seismicindustries/TT/info/linux_commands_for_AP_Client_mode_stuff_terminal_tedium.rtf

IP setzen
*********

ifconfig eth0 10.0.0.1

IP loeschen
***********

ifconfig eth0 0.0.0.0 - testen… sollte auch alle ips löschen vom interface

Use ip from iproute2. (You need to also specify the prefix length though.)
ip addr del 10.22.30.44/16 dev eth0

To remove all addresses (in case you have multiple):
ip addr flush dev eth0

DHCP start stop
***************

Restart the DCHP Service so that it will load your new settings:
service isc-dhcpd-server stop
service isc-dhcpd-server start
