seismicindustries/TT/(list of files, drawings)

Other design files:
TT.dsn
