seismicindustries/TT/TT.kicad_pcb

## KiCad design TT.kicad_pcb (2018-06-29)

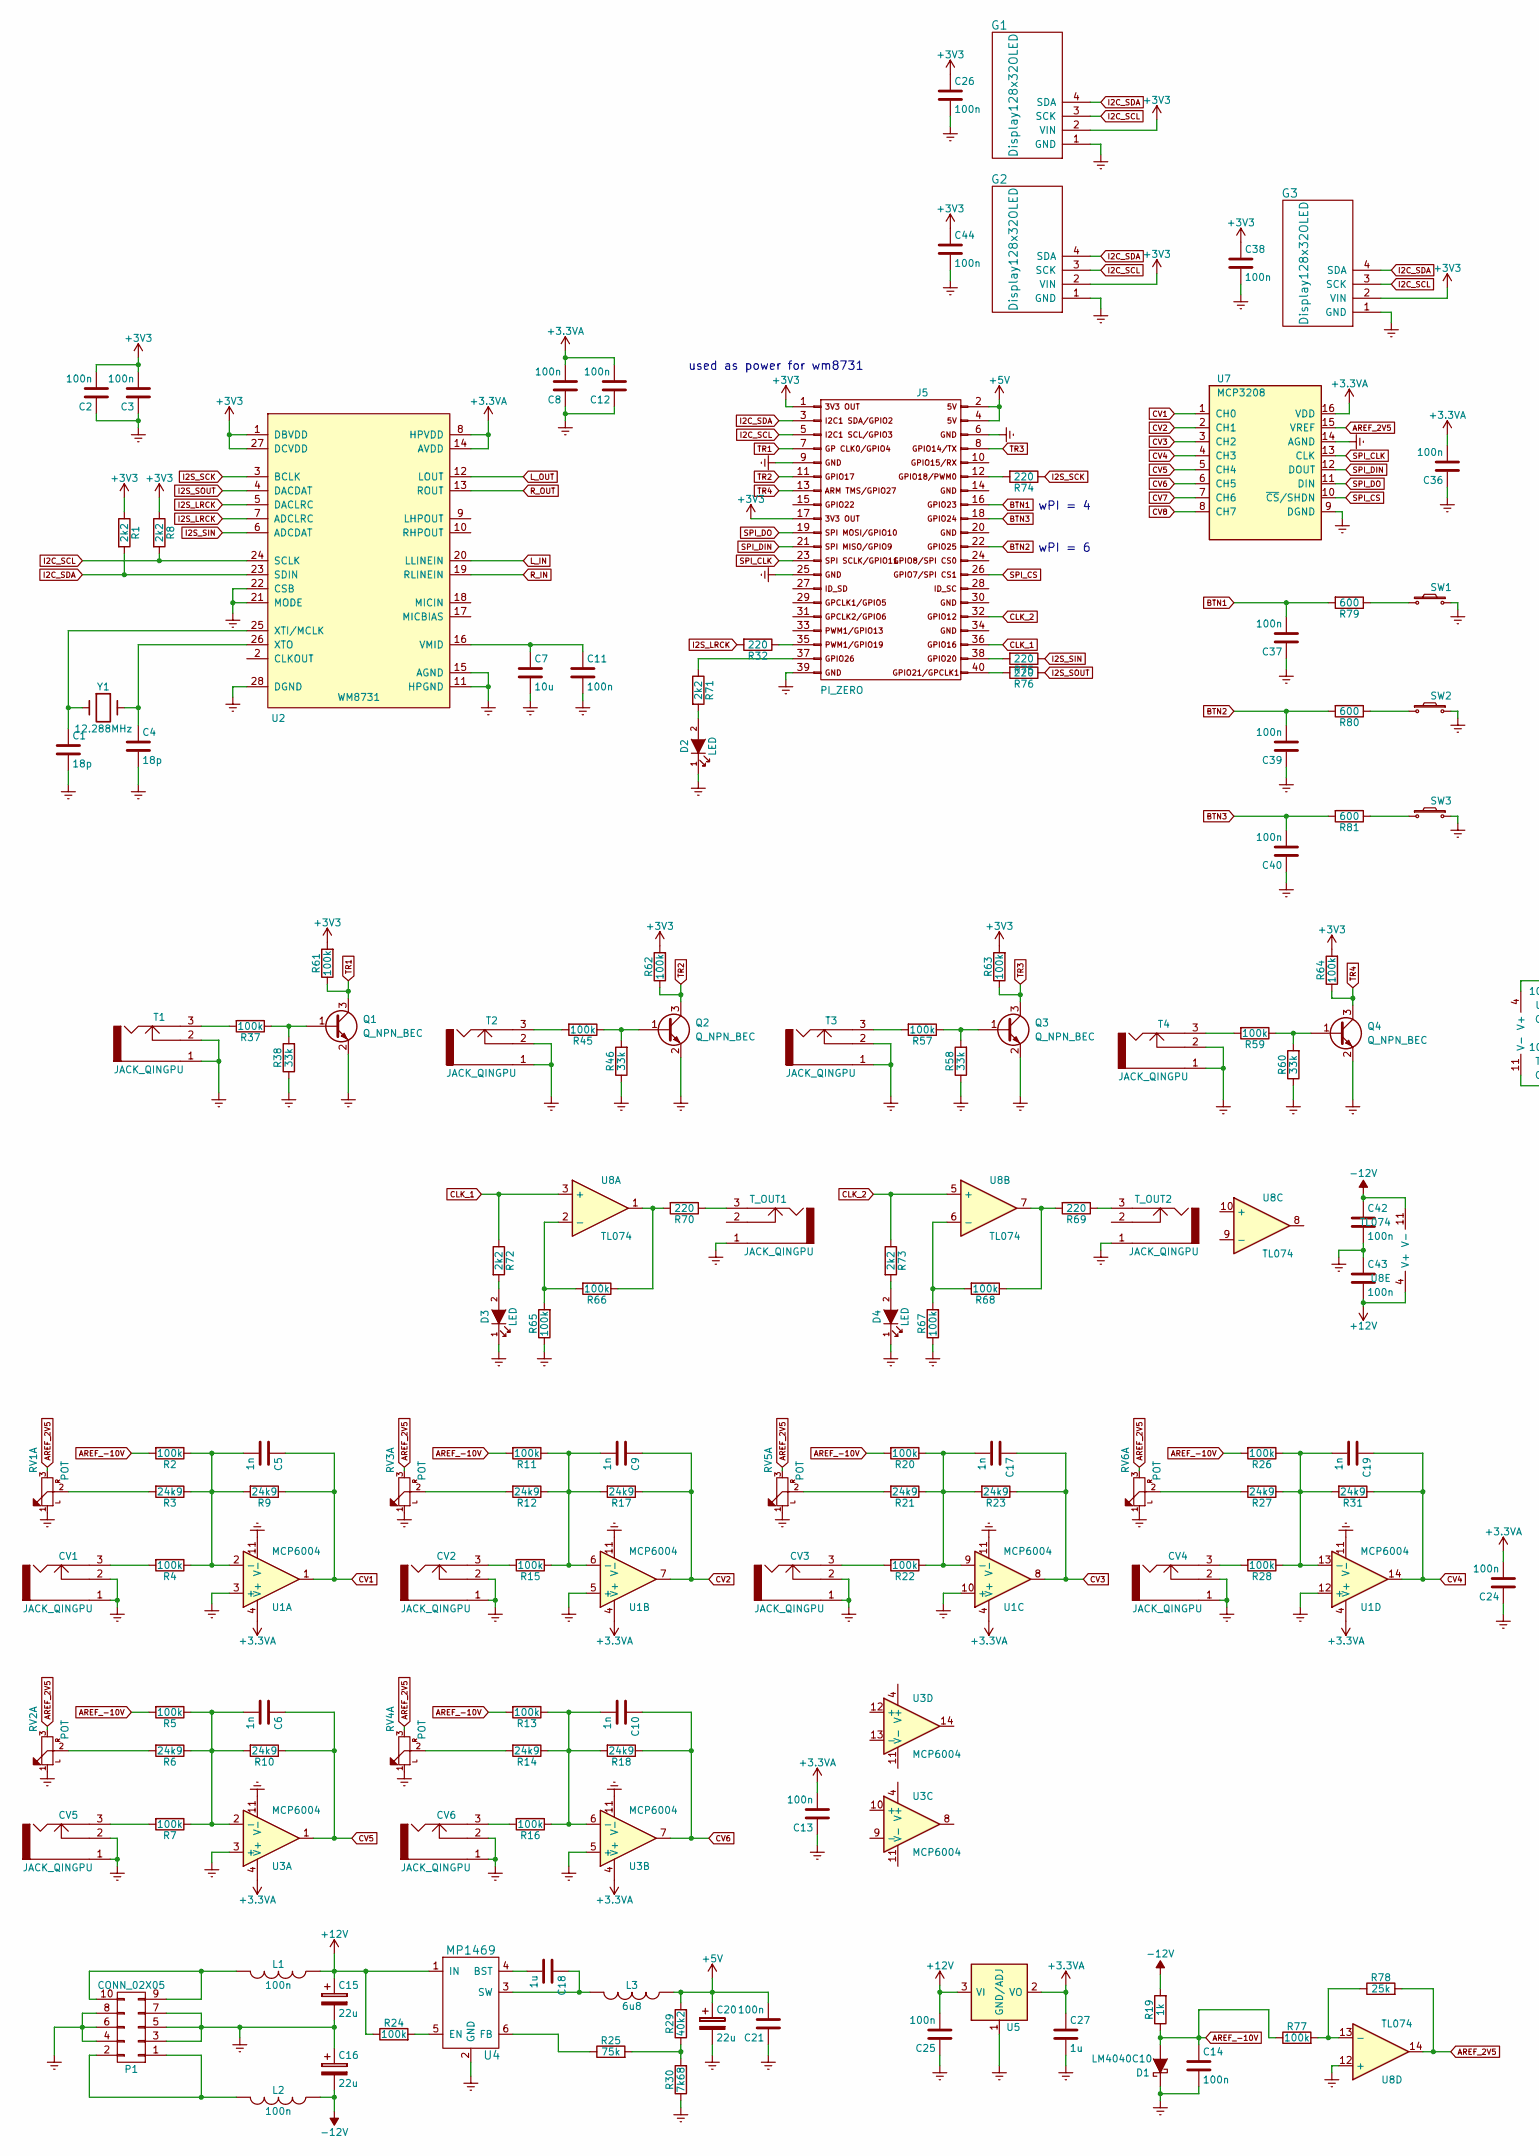
[picture p1: schematic TT.sch, TT remake, part in row 1, column 1]

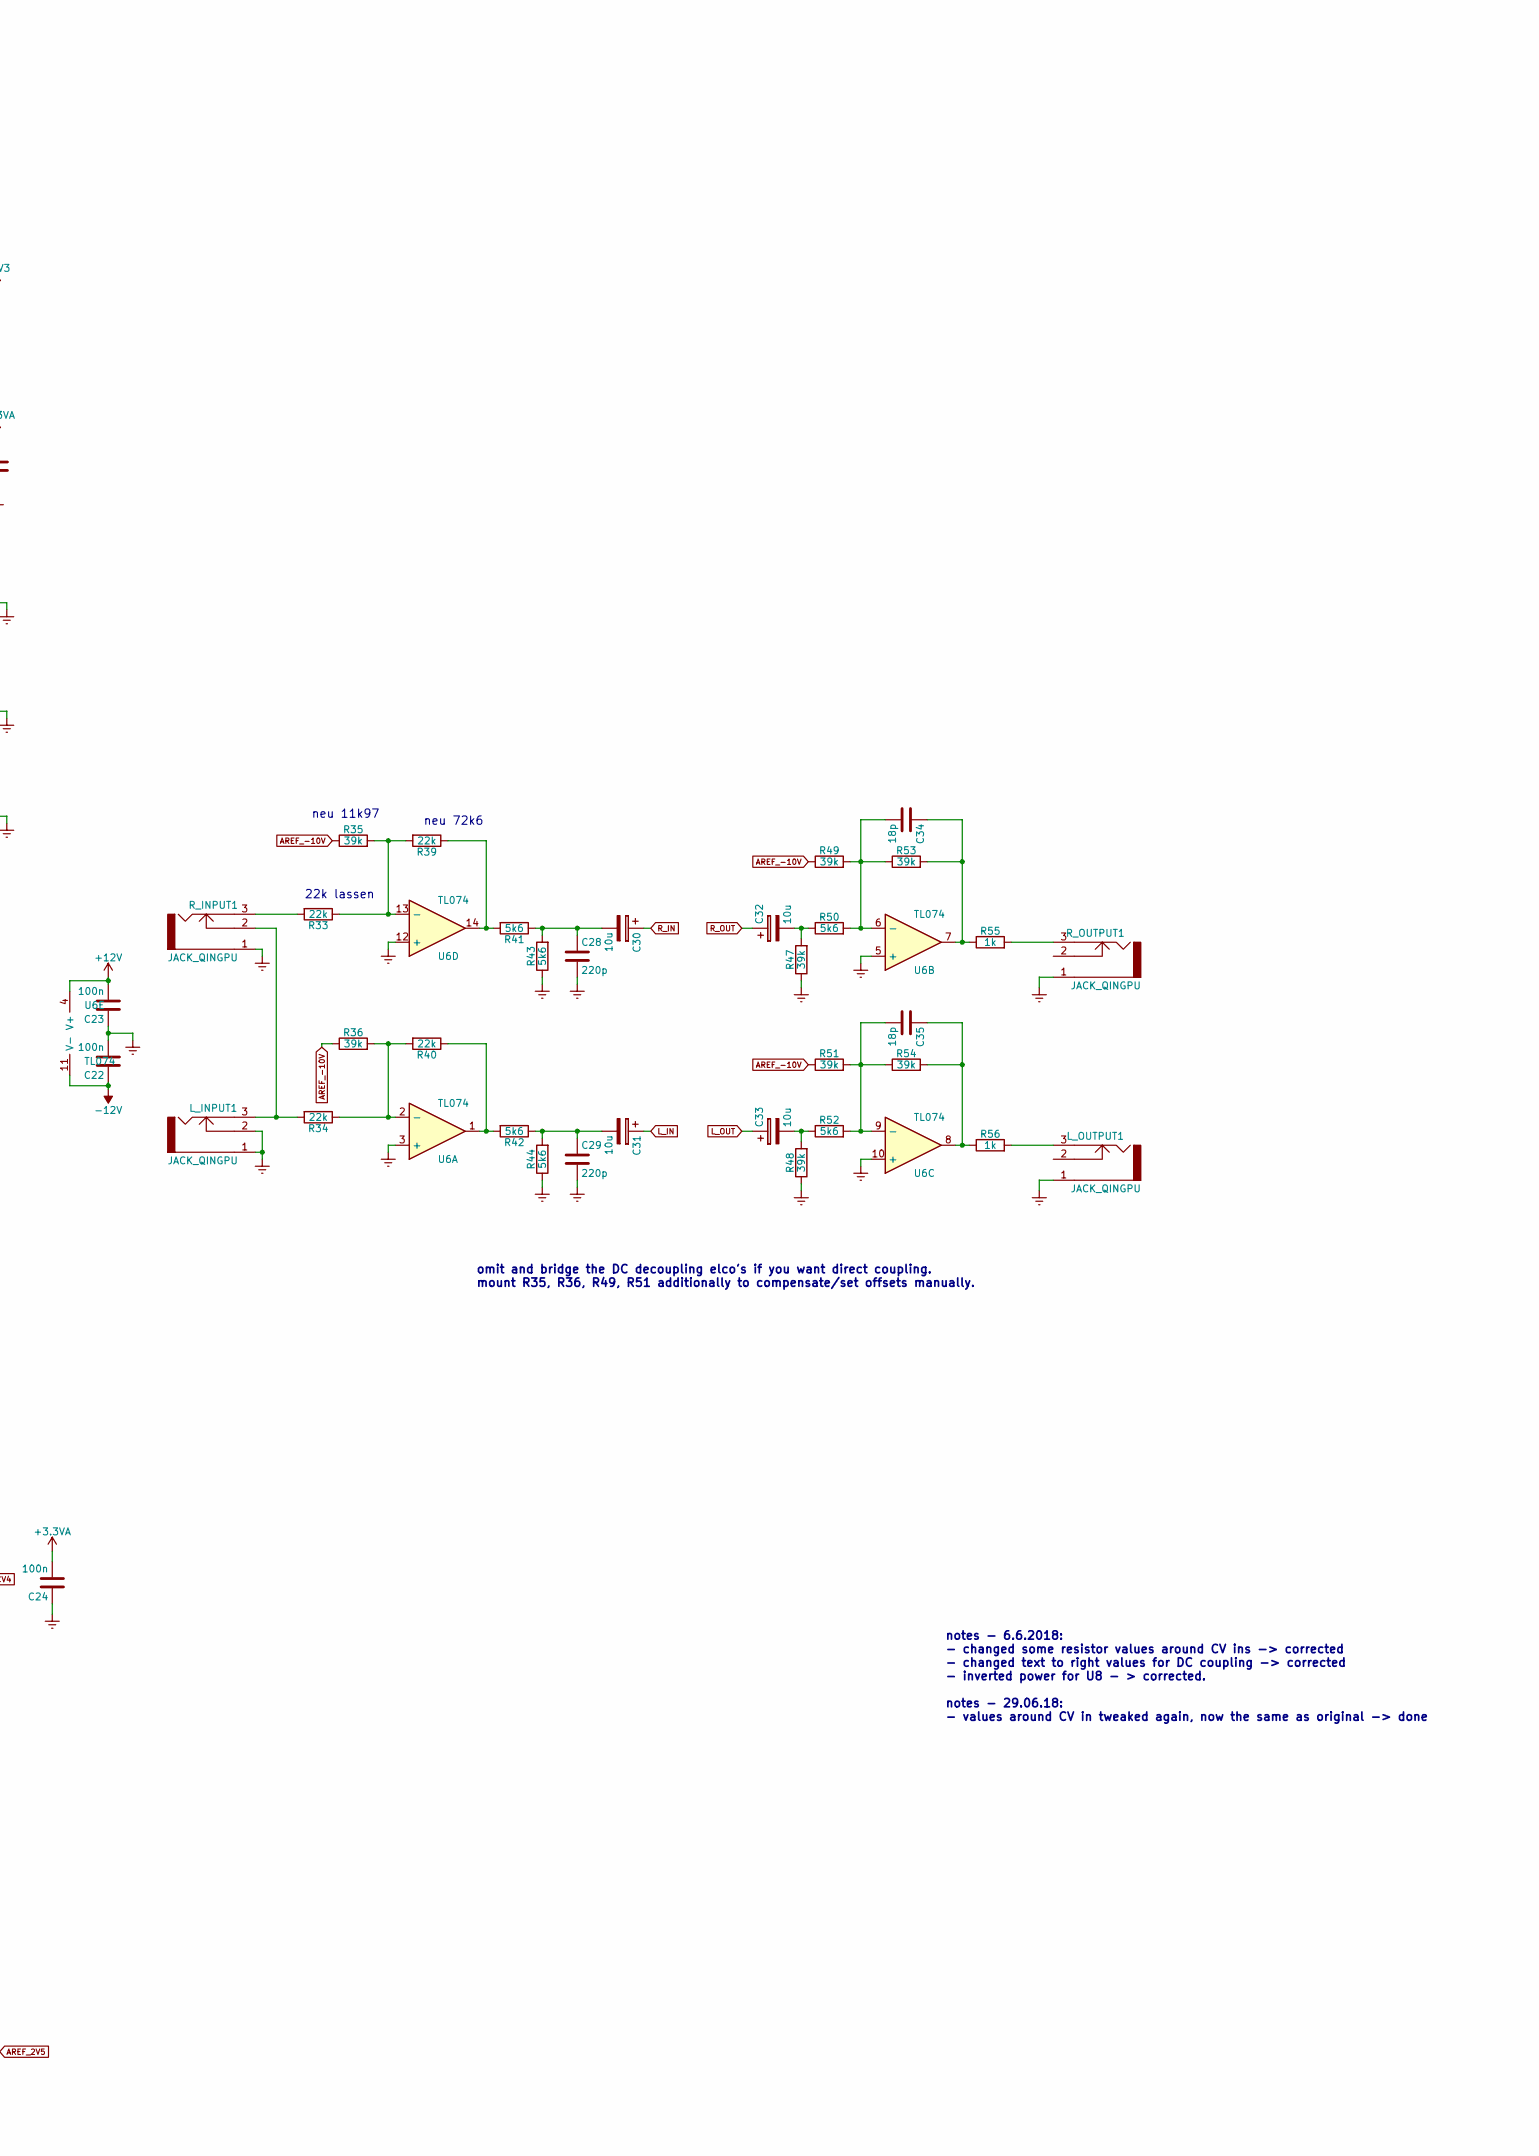
[picture p2: schematic TT.sch, TT remake, part in row 1, column 2]

Parts:
C1, C4, C34, C35: 18p; C_0603; MPN VJ0603A180JXACW1BC
C2, C3, C8, C11, C12, C13, C14, C21, C22, C23, C24, C25, C26, C36, C37, C38, C39, C40, C42, C43, C44: 100n; C_0603; MPN 885012206095
C5, C6, C9, C10, C17, C19: 1n; C_0603; MPN GRM1885C1H102JA01D
C7: 10u; C_0603; Mouser Part Nr 810-C1608X5R0J106M
C15, C16, C20: 22u; CP_Elec_7.3x4.3; MPN EEF-CX1D220R
C18, C27: 1u; C_0603; MPN 885012206095
C28, C29: 220p; C_0603; MPN GRM1885C1H221JA01J
C30, C31, C32, C33: 10u; C_Radial_D4_L7; MPN UPW1E100MDD6
CV1, CV2, CV3, CV4, CV5, CV6: JACK_QINGPU; jack_qingpu
D1: LM4040C10; SOT-23; MPN LM4040C10IDBZR
D2, D3, D4: LED; LED_D3.0mm; MPN LTL-4231N
G1, G2, G3: Display128x32OLED; oled_128x32
J5: PI_ZERO
L1, L2: 100n; Inductor_PSU_NLCV32T; MPN NLCV32T-R10M-PFR
L3: 6u8; Inductor_SRN4018TA_bourns; MPN SRN4018TA-6R8M
L_INPUT1: JACK_QINGPU; jack_qingpu
L_OUTPUT1: JACK_QINGPU; jack_qingpu
P1: CONN_02X05; Pin_Header_Angled_2x05_Pitch2.54mm_with_space_for_con; MPN 649-68020-110HLF
Q1, Q2, Q3, Q4: Q_NPN_BEC; SOT-23; MPN BC847CLT1G
R1, R8, R71, R72, R73: 2k2; R_0603; MPN RC0603FR-072K2L
R2, R5, R11, R13, R20, R26: 100k; R_0603; MPN RC0603FR-07200KL
R3, R6, R12, R14, R21, R27: 24k9; R_0603; MPN RCA0603100KJNEC
R4, R7, R15, R16, R22, R24, R28, R37, R45, R57, R59, R61, R62, R63, R64, R65, R66, R67, R68, R77: 100k; R_0603; MPN RCA0603100KJNEC
R9, R10, R17, R18, R23, R31: 24k9; R_0603; MPN ERJ-3GEYJ333V
R19: 1k; R_0603; MPN ERJ-3GEYJ333V
R25: 75k; R_0603; MPN CR0603-FX-2202ELF
R29: 40k2; R_0603; MPN CR0603-FX-2202ELF
R30: 7k68; R_0603; MPN CR0603-FX-2202ELF
R32, R69, R70, R74, R75, R76: 220; R_0603; MPN RCA0603100KJNEC
R33, R34, R39, R40: 22k; R_0603; MPN CR0603-FX-2202ELF
R35, R36, R47, R48, R49, R51, R53, R54: 39k; R_0603; MPN ERJ-3GEYJ393V
R38, R46, R58, R60: 33k; R_0603; MPN ERJ-3GEYJ333V
R41, R42, R43, R44, R50, R52: 5k6; R_0603; MPN CR0603-FX-5601ELF
R55, R56: 1k; R_0603; MPN RC0603FR-071KL
R78: 25k; R_0603; MPN ERJ-3GEYJ333V
R79, R80, R81: 600; R_0603; MPN RCA0603100KJNEC
RV1, RV2, RV3, RV4, RV5, RV6: POT; Potentiometer_ALPHA_RV112
R_INPUT1: JACK_QINGPU; jack_qingpu
R_OUTPUT1: JACK_QINGPU; jack_qingpu
SW1, SW2, SW3: SW_PUSH_SMALL_H; APEM_tactile_SMD_switch_6mm; MPN ADTSM66NV
T1, T2, T3, T4: JACK_QINGPU; jack_qingpu
T_OUT1, T_OUT2: JACK_QINGPU; jack_qingpu
U1, U3: MCP6004; SOIC-14_N; MPN MCP6004T-I/SL SOIC-14 variant
U2: WM8731; SSOP-28_5.3x10.2mm_Pitch0.65mm; MPN WM8731SEDS/V
U4: MP1469; SOT-23-6; MPN MP1469GJ-Z
U5: SOT-223; MPN AZ1117IH-3.3TRG1 SOT-223-3 variant
U6, U8: TL074; SOIC-14_N; MPN 595-TL074CDR SOIC-14 variant
U7: MCP3208; SO-16-N
Y1: 12.288MHz; ABM7; Mouser Part Nr 815-ABM7-12.2-D2Y-T

Connections:
+3.3VA: C8.2, C12.2, C13.2, C24.2, C27.1, C36.2, U1.4 (V+), U2.8 (HPVDD), U2.14 (AVDD), U3.4 (V+), U5.2 (VO), U7.16 (VDD)
+3V3: C2.2, C3.2, C26.1, C38.1, C44.1, G1.2 (VIN), G2.2 (VIN), G3.2 (VIN), J5.1, J5.17, R1.1, R8.1, R61.2, R62.2, R63.2, R64.2, U2.1 (DBVDD), U2.27 (DCVDD)
+5V: C20.1, C21.2, J5.2, J5.4, L3.1, R29.2
+12V: C15.1, C23.2, C25.2, C43.2, L1.1, R24.1, U4.1 (IN), U5.3 (VI), U6.4 (V+), U8.4 (V+)
-12V: C16.2, C22.1, C42.1, L2.1, R19.2, U6.11 (V-), U8.11 (V-)
AREF_2V5: R78.2, RV1.3 (6), RV2.3 (6), RV3.3 (6), RV4.3 (6), RV5.3 (6), RV6.3 (6), U7.15 (VREF), U8.14
AREF_-10V: C14.1, D1.2 (A), R2.2, R5.2, R11.2, R13.2, R19.1, R20.2, R26.2, R35.1, R36.1, R49.1, R51.1, R77.1
BTN1: C37.2, J5.16, R79.2
BTN2: C39.2, J5.22, R80.2
BTN3: C40.2, J5.18, R81.2
CLK_1: J5.36, R72.1, U8.3 (+)
CLK_2: J5.32, R73.1, U8.5 (+)
CV1: C5.1, R9.1, U1.1, U7.1 (CH0)
CV2: C9.1, R17.1, U1.7, U7.2 (CH1)
CV3: C17.1, R23.1, U1.8, U7.3 (CH2)
CV4: C19.1, R31.1, U1.14, U7.4 (CH3)
CV5: C6.1, R10.1, U3.1, U7.5 (CH4)
CV6: C10.1, R18.1, U3.7, U7.6 (CH5)
Earth: C1.2, C2.1, C3.1, C4.2, C7.2, C8.1, C11.2, C12.1, C13.1, C14.2, C15.2, C16.1, C20.2, C21.1, C22.2, C23.1, C24.1, C25.1, C26.2, C27.2, C28.2, C29.2, C36.1, C37.1, C38.2, C39.1, C40.1, C42.2, C43.1, C44.2, CV1.1, CV1.2, CV2.1, CV2.2, CV3.1, CV3.2, CV4.1, CV4.2, CV5.1, CV5.2, CV6.1, CV6.2, D1.1 (K), D2.1 (K), D3.1 (K), D4.1 (K), G1.1 (GND), G2.1 (GND), G3.1 (GND), J5.6, J5.9, J5.25, J5.39, L_INPUT1.1, L_INPUT1.2, L_OUTPUT1.1, P1.3, P1.4, P1.5, P1.6, P1.7, P1.8, Q1.2 (E), Q2.2 (E), Q3.2 (E), Q4.2 (E), R30.1, R38.1, R43.1, R44.1, R46.1, R47.1, R48.1, R58.1, R60.1, R65.1, R67.1, RV1.1 (4), RV2.1 (4), RV3.1 (4), RV4.1 (4), RV5.1 (4), RV6.1 (4), R_INPUT1.1, R_OUTPUT1.1, SW1.2, SW2.2, SW3.2, T1.1, T1.2, T2.1, T2.2, T3.1, T3.2, T4.1, T4.2, T_OUT1.1, T_OUT2.1, U1.3 (+), U1.5 (+), U1.10 (+), U1.11 (V-), U1.12 (+), U2.11 (HPGND), U2.15 (AGND), U2.21 (MODE), U2.22 (CSB), U2.28 (DGND), U3.3 (+), U3.5 (+), U3.11 (V-), U4.2 (GND), U5.1 (GND/ADJ), U6.3 (+), U6.5 (+), U6.10 (+), U6.12 (+), U7.9 (DGND), U7.14 (AGND), U8.12 (+)
I2C_SCL: G1.3 (SCK), G2.3 (SCK), G3.3 (SCK), J5.5, R8.2, U2.24 (SCLK)
I2C_SDA: G1.4 (SDA), G2.4 (SDA), G3.4 (SDA), J5.3, R1.2, U2.23 (SDIN)
I2S_LRCK: R32.2, U2.5 (DACLRC), U2.7 (ADCLRC)
I2S_SCK: R74.1, U2.3 (BCLK)
I2S_SIN: R75.1, U2.6 (ADCDAT)
I2S_SOUT: R76.1, U2.4 (DACDAT)
L_IN: C31.1, U2.20 (LLINEIN)
L_OUT: C33.1, U2.12 (LOUT)
unnamed: C1.1, U2.25 (XTI/MCLK), Y1.1
unnamed: C4.1, U2.26 (XTO), Y1.2
unnamed: C5.2, R2.1, R3.1, R4.1, R9.2, U1.2 (-)
unnamed: C6.2, R5.1, R6.1, R7.1, R10.2, U3.2 (-)
unnamed: C9.2, R11.1, R12.1, R15.1, R17.2, U1.6 (-)
unnamed: C10.2, R13.1, R14.1, R16.1, R18.2, U3.6 (-)
unnamed: C7.1, C11.1, U2.16 (VMID)
unnamed: C17.2, R20.1, R21.1, R22.1, R23.2, U1.9 (-)
unnamed: C18.1, L3.2, U4.3 (SW)
unnamed: C18.2, U4.4 (BST)
unnamed: C19.2, R26.1, R27.1, R28.1, R31.2, U1.13 (-)
unnamed: C28.1, C30.2, R41.1, R43.2
unnamed: C29.1, C31.2, R42.1, R44.2
unnamed: C32.2, R47.2, R50.1
unnamed: C33.2, R48.2, R52.1
unnamed: C34.1, R53.2, R55.1, U6.7
unnamed: C34.2, R49.2, R50.2, R53.1, U6.6 (-)
unnamed: C35.1, R54.2, R56.1, U6.8
unnamed: C35.2, R51.2, R52.2, R54.1, U6.9 (-)
unnamed: CV1.3, R4.2
unnamed: CV2.3, R15.2
unnamed: CV3.3, R22.2
unnamed: CV4.3, R28.2
unnamed: CV5.3, R7.2
unnamed: CV6.3, R16.2
unnamed: D2.2 (A), R71.2
unnamed: D3.2 (A), R72.2
unnamed: D4.2 (A), R73.2
unnamed: J5.12, R74.2
unnamed: J5.35, R32.1
unnamed: J5.37, R71.1
unnamed: J5.38, R75.2
unnamed: J5.40, R76.2
unnamed: L1.2, P1.9, P1.10
unnamed: L2.2, P1.1, P1.2
unnamed: L_INPUT1.3, R34.2, R_INPUT1.2
unnamed: L_OUTPUT1.3, R56.2
unnamed: Q1.1 (B), R37.1, R38.2
unnamed: Q2.1 (B), R45.1, R46.2
unnamed: Q3.1 (B), R57.1, R58.2
unnamed: Q4.1 (B), R59.1, R60.2
unnamed: R3.2, RV1.2 (5)
unnamed: R6.2, RV2.2 (5)
unnamed: R12.2, RV3.2 (5)
unnamed: R14.2, RV4.2 (5)
unnamed: R21.2, RV5.2 (5)
unnamed: R24.2, U4.5 (EN)
unnamed: R25.1, U4.6 (FB)
unnamed: R25.2, R29.1, R30.2
unnamed: R27.2, RV6.2 (5)
unnamed: R33.1, R35.2, R39.2, U6.13 (-)
unnamed: R33.2, R_INPUT1.3
unnamed: R34.1, R36.2, R40.2, U6.2 (-)
unnamed: R37.2, T1.3
unnamed: R39.1, R41.2, U6.14
unnamed: R40.1, R42.2, U6.1
unnamed: R45.2, T2.3
unnamed: R55.2, R_OUTPUT1.3
unnamed: R57.2, T3.3
unnamed: R59.2, T4.3
unnamed: R65.2, R66.2, U8.2 (-)
unnamed: R66.1, R70.2, U8.1
unnamed: R67.2, R68.2, U8.6 (-)
unnamed: R68.1, R69.2, U8.7
unnamed: R69.1, T_OUT2.3
unnamed: R70.1, T_OUT1.3
unnamed: R77.2, R78.1, U8.13 (-)
unnamed: R79.1, SW1.1
unnamed: R80.1, SW2.1
unnamed: R81.1, SW3.1
R_IN: C30.1, U2.19 (RLINEIN)
R_OUT: C32.1, U2.13 (ROUT)
SPI_CLK: J5.23, U7.13 (CLK)
SPI_CS: J5.26, U7.10 (~CS~/SHDN)
SPI_DIN: J5.21, U7.12 (DOUT)
SPI_DO: J5.19, U7.11 (DIN)
TR1: J5.7, Q1.3 (C), R61.1
TR2: J5.11, Q2.3 (C), R62.1
TR3: J5.8, Q3.3 (C), R63.1
TR4: J5.13, Q4.3 (C), R64.1

Notes on the sheet:
omit and bridge the DC decoupling elco's if you want direct coupling. mount R35, R36, R49, R51 additionally to compensate/set offsets manually.
neu 72k6
22k lassen
neu 11k97
used as power for wm8731
wPI = 4
wPI = 6
notes - 6.6.2018: - changed some resistor values around CV ins -> corrected - changed text to right values for DC coupling -> corrected - inverted power for U8 - > corrected. notes - 29.06.18: - values around CV in tweaked again, now the same as original -> done

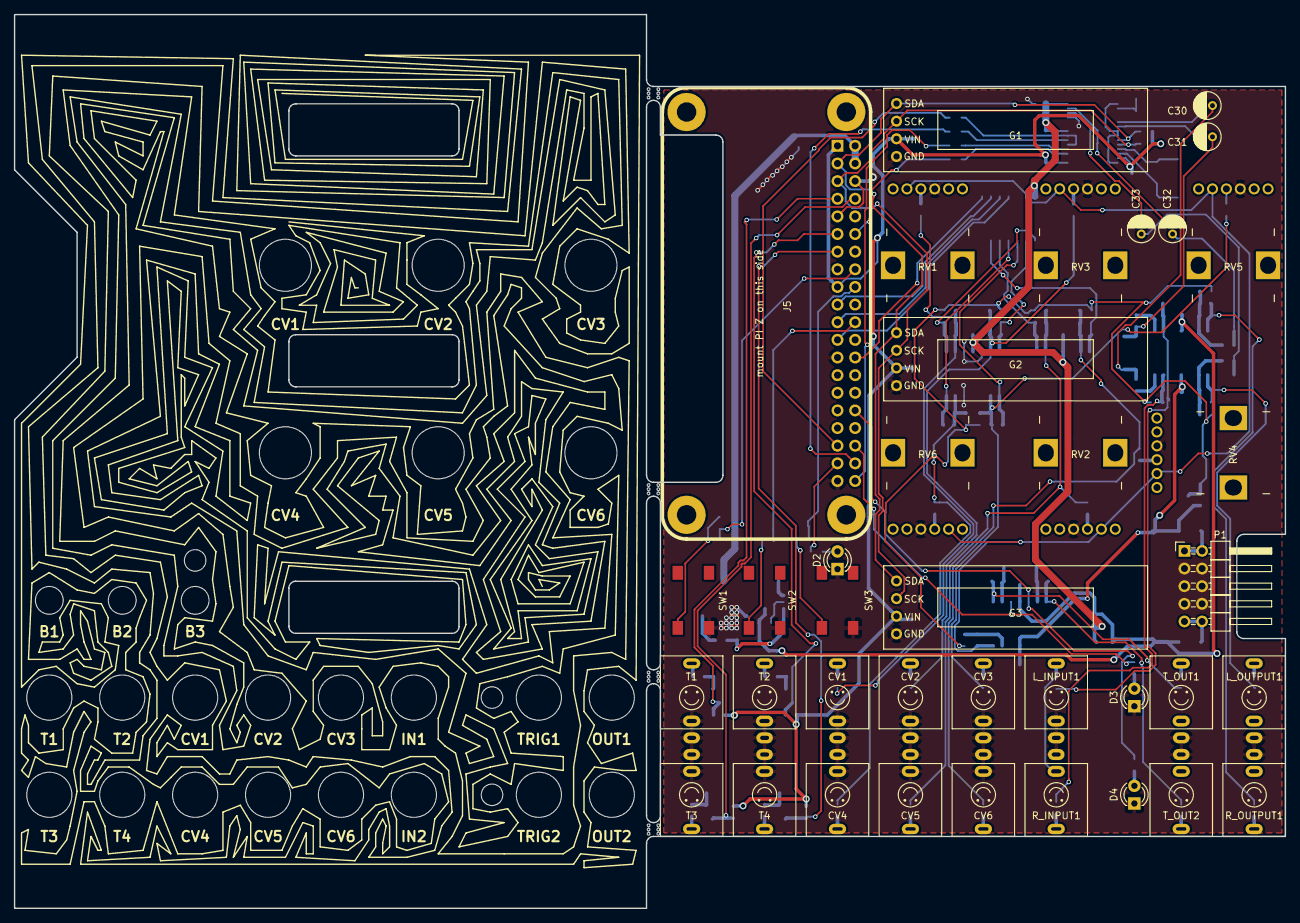
[picture p3: board TT.kicad_pcb from above]

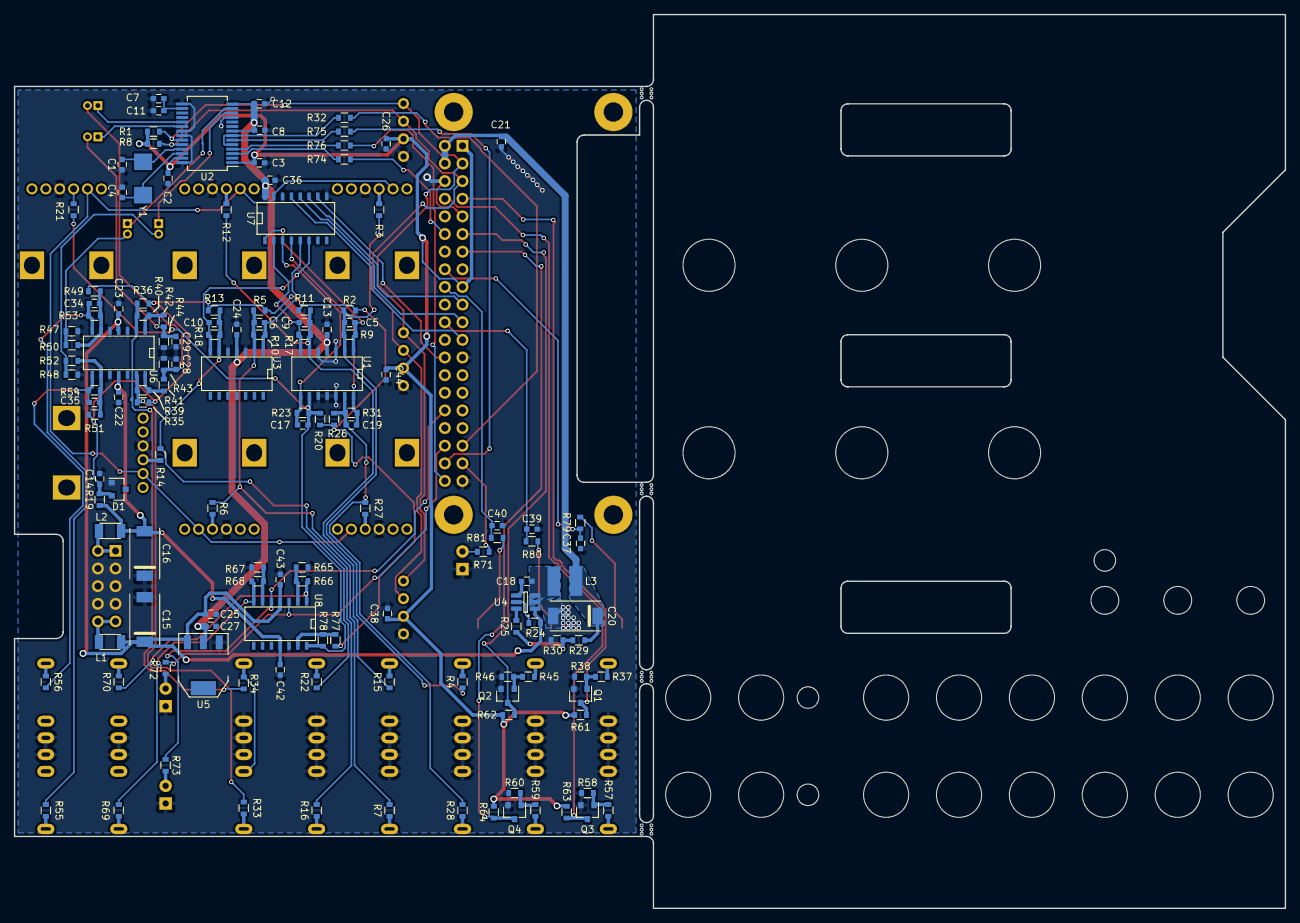
[picture p4: board TT.kicad_pcb from below]

Board: 2 copper layers, 183.0 x 128.7 mm, 174 parts (137 on the bottom side), 107 nets.
