seismicindustries/TT/(commit log)

2018-05-30 first upload
    [TT-B.Cu.gbr, TT-B.Mask.gbr, TT-B.SilkS.gbr, TT-Cmts.User.gbr, TT-Edge.Cuts.gbr, TT-F.Cu.gbr, TT-F.Mask.gbr, TT-F.SilkS.gbr]
2018-05-30 .sch cleanup
    [TT.sch]
2018-06-06 corrected some values and the power inversion of U8
    [TT.kicad_pcb, TT.sch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]
2018-06-29 CV input stage values tweaked to original
    [TT.kicad_pcb, TT.sch]
